haibv10/do-an-thiet-ke-he-thong-so/sw/app/main.c

#include "sys_delay.h"
#include "gpio_led.h"
#include "uart_io.h"
#include "ds3231_rtc.h"
#include "st7735_panel.h"
#include "ui_clock.h"
#include "spi_bus.h"
#include "mq5_sensor.h"
#include "dht11_sensor.h"

// Startup must copy .data from ROM and clear .bss; volatile keeps the check real.
volatile unsigned int data_marker = 0x5a5a5a5a;
volatile unsigned int bss_marker;

int main(void) {
  unsigned char time[DS3231_TIME_BYTES];
  unsigned char last_second = 0xff;
  unsigned int led = 0;
  unsigned int rtc_time_trusted;
  unsigned char command;
  unsigned int gas_tick = 0;
  unsigned int gas_mv;
  unsigned int dht_tick = 0;
  unsigned int dht_pending = 0;
  unsigned int dht_status;
  unsigned int display_fault_reported = 0;
  unsigned char humidity;
  unsigned char temperature;

  led_set(0);

  if (data_marker == 0x5a5a5a5au && bss_marker == 0u) {
    uart_puts("BOOT OK\r\n");
  } else {
    uart_puts("BOOT FAIL data=");
    uart_hex32(data_marker);
    uart_puts(" bss=");
    uart_hex32(bss_marker);
    uart_puts("\r\n");
  }

  tft_init();

  rtc_time_trusted = ds3231_report_osf();

  ui_draw_frame();

  while (1) {
    if (spi_error() && !display_fault_reported) {
      uart_puts("DISPLAY SPI TIMEOUT\r\n");
      display_fault_reported = 1;
    }
    if (uart_poll(&command)) {
      if (command == 'W' && ds3231_set_from_uart())
        rtc_time_trusted = 1;
      else if (command == 'P')
        ui_toggle_page();
    }

    if (++gas_tick >= 10u) {
      gas_tick = 0;
      if (mq5_read_mv(&gas_mv))
        ui_show_gas(gas_mv, mq5_level_of(gas_mv));
      else
        ui_show_gas_fault();
    }

    if (!dht_pending && ++dht_tick >= 40u) {
      dht_tick = 0;
      dht11_start();
      dht_pending = 1;
    }
    if (dht_pending) {
      dht_status = dht11_status();
      if (!(dht_status & DHT11_BUSY)) {
        if (dht11_read(&humidity, &temperature))
          ui_show_environment(temperature, humidity);
        else
          ui_show_environment_fault();
        dht_pending = 0;
      }
    }

    if (!ds3231_read_time(time)) {
      uart_puts("RTC NACK\r\n");
      ui_show_rtc_fault();
      delay_loop(DELAY_MS(1000));
      continue;
    }

    if (time[0] != last_second) {
      last_second = time[0];
      if (rtc_time_trusted && ds3231_time_is_valid(time)) {
        ds3231_print(time);
        ui_show_time(time);
      } else {
        uart_puts("RTC INVALID\r\n");
        ui_show_unset();
      }
      led = led ^ 1u;
      led_set(led);
    }

    delay_loop(DELAY_MS(50));
  }
}
