haibv10/do-an-thiet-ke-he-thong-so/tb/integration/cpu_spi_tb.sv

`timescale 1ns / 1ps

module cpu_spi_tb;
  logic         clk = 1'b0;
  logic         rst_n = 1'b0;
  wire          led_out;
  wire          uart_tx_out;
  wire          spi_sck_out;
  wire          spi_mosi_out;
  wire          spi_cs_n_out;
  wire          spi_dc_out;
  wire          spi_rst_n_out;
  tri1          i2c_sda;
  tri1          i2c_scl;

  time last_sck_rise = 0;
  integer checked_widths = 0;
  always @(posedge spi_sck_out) last_sck_rise = $time;
  always @(negedge spi_sck_out) if (rst_n && last_sck_rise) begin
    if ($time - last_sck_rise != 37)
      $fatal(1, "SPI high width must be one system clock (13.5 MHz at 27 MHz)");
    checked_widths = checked_widths + 1;
  end

  integer       index;
  integer       bit_count = 0;
  integer       byte_count = 0;
  logic   [7:0] shift = 8'd0;
  logic   [7:0] seen_byte      [0:3];
  logic         seen_dc        [0:3];

  always #18.5 clk = ~clk;

  soc_top dut (
    .clk          (clk),
    .rst_n        (rst_n),
    .led_out      (led_out),
    .uart_rx_in   (1'b1),
    .uart_tx_out  (uart_tx_out),
    .i2c_sda      (i2c_sda),
    .i2c_scl      (i2c_scl),
    .spi_sck_out  (spi_sck_out),
    .spi_mosi_out (spi_mosi_out),
    .spi_cs_n_out (spi_cs_n_out),
    .spi_dc_out   (spi_dc_out),
    .spi_rst_n_out(spi_rst_n_out)
  );

  always @(posedge spi_sck_out) begin
    if (rst_n) begin
      shift     = {shift[6:0], spi_mosi_out};
      bit_count = bit_count + 1;
      if (bit_count == 8) begin
        if (byte_count < 4) begin
          seen_byte[byte_count] = shift;
          seen_dc[byte_count]   = spi_dc_out;
        end
        byte_count = byte_count + 1;
        bit_count  = 0;
      end
    end
  end

  initial begin
    #4000000;
    $fatal(1, "timeout after %0d bytes", byte_count);
  end

  initial begin
    #1;
    for (index = 0; index < $size(dut.rom.rom); index = index + 1) dut.rom.rom[index] = 32'h0000_0013;

    dut.rom.rom[0]  = 32'h7000_02b7;
    dut.rom.rom[1]  = 32'h0040_0313;
    dut.rom.rom[2]  = 32'h0062_a423;
    dut.rom.rom[3]  = 32'h03a0_0313;
    dut.rom.rom[4]  = 32'h0062_a023;
    dut.rom.rom[5]  = 32'h0042_a383;
    dut.rom.rom[6]  = 32'h0013_f393;
    dut.rom.rom[7]  = 32'hfe03_9ce3;
    dut.rom.rom[8]  = 32'h0060_0313;
    dut.rom.rom[9]  = 32'h0062_a423;
    dut.rom.rom[10] = 32'h0550_0313;
    dut.rom.rom[11] = 32'h0062_a023;
    dut.rom.rom[12] = 32'h0042_a383;
    dut.rom.rom[13] = 32'h0013_f393;
    dut.rom.rom[14] = 32'hfe03_9ce3;
    dut.rom.rom[15] = 32'h0050_0313;
    dut.rom.rom[16] = 32'h0062_a423;
    dut.rom.rom[17] = 32'h0000_006f;

    repeat (2) @(posedge clk);
    #1;
    if (spi_cs_n_out !== 1'b1) $fatal(1, "cs_n = %b during reset", spi_cs_n_out);
    if (spi_rst_n_out !== 1'b0) $fatal(1, "panel rst_n = %b during reset", spi_rst_n_out);
    if (spi_sck_out !== 1'b0) $fatal(1, "sck = %b during reset", spi_sck_out);

    @(negedge clk) rst_n = 1'b1;

    wait (byte_count == 2);
    repeat (200) @(posedge clk);

    if (byte_count !== 2) $fatal(1, "%0d bytes on the wire, expected 2", byte_count);
    if (seen_byte[0] !== 8'h3a) $fatal(1, "first byte %h, expected 3a", seen_byte[0]);
    if (seen_dc[0] !== 1'b0) $fatal(1, "dc = %b for the command byte, expected 0", seen_dc[0]);
    if (seen_byte[1] !== 8'h55) $fatal(1, "second byte %h, expected 55", seen_byte[1]);
    if (seen_dc[1] !== 1'b1) $fatal(1, "dc = %b for the parameter byte, expected 1", seen_dc[1]);

    if (spi_cs_n_out !== 1'b1) $fatal(1, "cs_n = %b after the deselect store", spi_cs_n_out);
    if (spi_rst_n_out !== 1'b1)
      $fatal(1, "panel rst_n = %b after firmware released it", spi_rst_n_out);

    if (!checked_widths) $fatal(1, "No SPI widths checked");
    $display("cpu_spi_tb: PASS (13.5 MHz divider)");
    $finish;
  end
endmodule
