haibv10/do-an-thiet-ke-he-thong-so/source/memory/mem_instruction_rom.v

module mem_instruction_rom #(
  parameter HEX_PATH = "rom/firmware.hex"
) (
  input  wire        clk,
  input  wire [31:0] a,
  output reg  [31:0] rd,

  input  wire [31:0] a_data,
  output reg  [31:0] rd_data
);
  reg     [31:0] rom   [0:4095];
  integer        index;

  initial begin

    // synthesis translate_off
    for (index = 0; index < 4096; index = index + 1) begin
      rom[index] = 32'd0;
    end
    // synthesis translate_on
    $readmemh(HEX_PATH, rom);
  end

  always @(negedge clk) begin
    rd      <= rom[a[13:2]];
    rd_data <= rom[a_data[13:2]];
  end
endmodule
