haibv10/do-an-thiet-ke-he-thong-so/source/peripheral/i2c/i2c_mmio.v

module i2c_mmio (
  input  wire        clk,
  input  wire        tick,
  input  wire        rst_n,
  input  wire        we,
  input  wire [31:0] a,
  input  wire [31:0] wd,
  output reg  [31:0] rd,
  inout  wire        sda,
  inout  wire        scl
);

  wire       frame_busy;
  wire       frame_ack;
  wire [7:0] frame_data;

  reg        en;
  reg        busy;
  reg  [7:0] tx_data;
  reg        start_frame;
  reg        stop_frame;
  reg        rw;
  reg        ack_out;

  wire       launch = we && (a[7:0] == 8'h00) && !busy;

  i2c_master master_inst (
    .clk        (clk),
    .tick       (tick),
    .rst_n      (rst_n),
    .en         (en),
    .rw         (rw),
    .start_frame(start_frame),
    .stop_frame (stop_frame),
    .ack_out    (ack_out),
    .data       (tx_data),
    .sda        (sda),
    .scl        (scl),
    .done       (),
    .busy       (frame_busy),
    .data_out   (frame_data),
    .ack        (frame_ack),
    .sda_en     ()
  );

  always @(posedge clk or negedge rst_n) begin
    if (!rst_n) begin
      en          <= 1'b0;
      busy        <= 1'b0;
      tx_data     <= 8'd0;
      start_frame <= 1'b0;
      stop_frame  <= 1'b0;
      rw          <= 1'b0;
      ack_out     <= 1'b0;
    end else if (launch) begin
      tx_data     <= wd[7:0];
      start_frame <= wd[8];
      stop_frame  <= wd[9];
      rw          <= wd[10];
      ack_out     <= wd[11];
      en          <= 1'b1;
      busy        <= 1'b1;
    end else if (en && frame_busy) begin
      en <= 1'b0;
    end else if (busy && !en && !frame_busy) begin
      busy <= 1'b0;
    end
  end

  always @(*) begin
    rd = 32'd0;
    case (a[7:0])
      8'h04: begin
        rd[0] = busy;
        rd[1] = frame_ack;
      end
      8'h08:   rd = {24'd0, frame_data};
      default: ;
    endcase
  end

endmodule
