haibv10/do-an-thiet-ke-he-thong-so/(commit log)

2026-08-13 docs: add initial README for RISC-V FPGA SoC
    Document the RV32I five-stage pipeline architecture, memory-mapped UART, GPIO, and I2C peripherals. Include the verified I2C LCD status, project scope, development roadmap, demo goals, verification strategy, and reference tools.
2026-08-24 chore: add repository guidance and ignore rules
    Document the RISC-V RV32I SoC architecture, peripheral responsibilities, FPGA scope, and current development direction.
    Add contributor guidance for SystemVerilog coding style, testing, development commands, and Conventional Commits.
    Ignore generated FPGA, simulation, build, coverage, editor, and temporary files.
2026-08-24 docs: add project documentation and coding rules
    Add I2C/LCD diagrams, waveforms, hardware references, Verilog coding conventions, and commit guidelines.
2026-08-24 feat(i2c): import lcd i2c controller
    Context:
    The LCD demo uses a PCF8574 adapter controlled through a 1 MHz I2C timing domain.
    Changes:
    Import the existing clock divider, I2C write-frame, LCD nibble writer, and LCD display controller without changing their Verilog behavior.
    Verification:
    Not run; no simulator is configured in the repository.
2026-09-06 feat(cpu): import board-tested five-stage pipeline
    The SoC targets the GW1NR-LV9QN88PC6/I5 board at 27 MHz. Team
    baseline commit 58c94bd provides the five-stage RV32I pipeline and its
    board-tested GPIO and UART path. Preserve that Verilog module and
    interface contract before later peripheral work changes the integration.
    Import the IF, ID, EX, MEM, and WB datapath, pipeline registers,
    forwarding, load-use stall detection, and branch and jump flushing. Add
    the 4 KiB instruction and data memories, MMIO decoder, GPIO, 115200 baud
    UART TX, RV32I firmware, and the validated board pin assignments.
    Keep the RTL behavior unchanged apart from replacing the developer
    machine readme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
    [cpu_top.v, main.c, make_hex.py, pipe_ex_mem.v, pipe_id_ex.v, pipe_if_id.v, pipe_mem_wb.v]
2026-09-06 test(cpu): add pipeline and MMIO regression
    The imported CPU baseline needs repeatable verification independent of
    the existing board build artifacts. The regression must cover pipeline
    control and the software-visible paths used by the current firmware.
    Add self-checking tests for the ALU, decoder, immediate generator,
    forwarding unit, load-use hazard detector, and four pipeline registers.
    Add a CPU integration program that exercises forwarding, a load-use
    stall, branch and JAL flushing, subword memory accesses, GPIO MMIO, and
    an 8N1 UART frame containing the byte 0x48.
    Add a test runner and document the GW1NR-LV9QN88PC6/I5 board target and
    the exact Icarus Verilog simu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
    [cpu_top_tb.sv, pipe_ex_mem_tb.sv, pipe_id_ex_tb.sv, pipe_if_id_tb.sv, pipe_mem_wb_tb.sv]
2026-09-07 test(cpu): fix integration test assumptions
    Icarus Verilog 11 rejects the unsigned integer localparam syntax used by
    the CPU integration test. Data Memory also leaves byte lanes undefined
    until software writes them, while the test incorrectly expected every
    unwritten lane to contain zero.
    Use a Verilog-compatible integer parameter for the UART bit period.
    Check only the byte lanes written by SB and SH, while continuing to
    verify signed and unsigned subword load results.
    Include the observed RAM and register values in the failure message so
    a future subword regression identifies the affected path directly.
    bash tb/run_tests.sh passes all ten tests, including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
    [cpu_top_tb.sv]
2026-09-07 build(fpga): add headless Tang Nano 9K flow
    The five-stage CPU baseline needs a reproducible terminal-only FPGA flow
    instead of relying on generated artifacts from another workstation. The
    target is a Tang Nano 9K with a GW1NR-LV9QN88PC6/I5 device and a 27 MHz
    onboard clock.
    Add the Gowin project, Tcl build description, and an explicit 27 MHz SDC
    constraint. Add a Linux wrapper that runs Gowin headlessly with a
    consistent Qt and libstdc++ environment on Ubuntu 22.04.
    Add an SRAM programming wrapper for the FT2232 FT2CH JTAG channel. Use
    SRAM Program without readback because operation 4 reports a verify
    failure at address zero on this target, while operation 2 completes an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
2026-09-07 chore(tooling): move build scripts to tools and output to build
    Runner, firmware, synthesis and programming scripts were scattered across the repository root, sw/ and tb/,
    and each one wrote generated artifacts next to its sources. Gowin emitted impl/ at the root and the RISC-V
    toolchain left ELF, BIN, ASM and MAP files inside sw/.
    Move build_fpga.sh, build_gowin.tcl, program_fpga.sh, tb/run_tests.sh and sw/make_hex.py into tools/, and
    add tools/build_firmware.sh for the RV32I cross-compile. Every script now resolves the repository root from
    its own location and writes to build/sim/, build/firmware/ and build/gowin/. tools/build_fpga.sh symlinks
    build/gowin/src so the rela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
    [make_hex.py]
2026-09-07 feat(uart): add UART RX with MMIO status and read-clear
    The CPU could only transmit. The MMIO decoder reserved 0x50000000 for UART but exposed a single write-only
    data register, so the pipeline had no way to observe incoming serial data on the Tang Nano 9K.
    Add uart_rx.v with a two-flop input synchronizer, start bit revalidation at the half-bit point, LSB-first
    assembly of eight data bits, and byte publication only when the stop bit is high. Add uart_mmio.v to wrap
    the transmitter and receiver behind one decode:
    0x00 write TX data
    0x04 read status, bit 0 tx_busy, bit 1 rx_valid
    0x08 read RX data, the load clears rx_valid
    Wire uart_mmio into cpu_top with a r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
2026-09-07 docs(verification): record UART RX evidence and branching model
    The verification note still described the transmit-only design and the old root-level script paths, and the
    branching model the team agreed on existed only in conversation.
    Update docs/verification/rv32i_pipeline.md with the twelve-test simulation scope, the current post-route
    numbers, the measured UART RX echo results, the single-byte receive buffer limitation, and a bring-up
    procedure. The procedure records three environment hazards found during this bring-up: a stale device
    configuration that emitted a repeated 0x56 until the byte-identical bitstream was reprogrammed, ftdi_sio
    binding the JTAG channel as /d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
2026-09-14 test(i2c): add lcd controller testbenches
    Add simulation coverage for the standalone I2C/LCD controller before it
    is integrated with the RV32I MMIO bus.
    The controller is split into timing generation, I2C frame transmission,
    LCD byte conversion, and LCD display sequencing. Add a focused testbench
    for each layer so failures can be isolated before CPU integration.
    - clk_divider_tb checks the configured output clock division.
    - i2c_writeframe_tb checks START, eight MSB-first data bits, slave ACK,
    STOP, and completion for one I2C frame.
    - lcd_write_cmd_data_tb checks the PCF8574 transfer sequence generated
    when writing an LCD data byte.
    - lcd_display_tb checks the LCD initialization sequen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
2026-09-14 test(uart): add loopback board diagnostic
    Add a self-contained UART loopback design for validating the alternate
    UART signal direction on the FPGA board without changing the CPU SoC
    top-level or its product pin constraints.
    The diagnostic top connects the selected UART output to the matching
    UART input and keeps the LED in a known state.
    - add the dedicated loopback top module and pin constraints
    - add a self-checking simulation for idle, low, and high signal levels
    - add headless Gowin build and programming commands for the diagnostic
    bitstream
2026-09-14 feat(lcd): switch display controller to 20x4
    Replace the fixed 16x2 display sequence with a four-line, 20-character
    controller for the PCF8574 LCD path.
    The controller now accepts four display rows and emits the DDRAM cursor
    commands required by a 20x4 HD44780-compatible display.
    - keep the initialization sequence and command/data write interface
    - add cursor commands 0x80, 0xC0, 0x94, and 0xD4 for the four rows
    - send 80 display characters after initialization
    - register cmd_data together with data so the control type remains
    aligned with the transmitted byte
    - extend the self-checking testbench to cover all 89 output bytes
    lcd_display_tb passes with Icarus Verilog.
2026-09-19 feat(i2c): add memory-mapped i2c peripheral for pcf8574 lcd
    Move the I2C path into the CPU 27 MHz clock domain and step it from a 1 MHz
    tick enable, so a one-cycle MMIO write strobe is no longer missed by a
    separately divided clock.
    The peripheral sits at base 0x60000000: offset 0x00 writes
    {cmd_data, data[7:0]}, 0x04 reads status {ack, busy}, 0x08 sets the 7-bit
    slave address.
    - replace clk_divider with clock_enable_divider as the 1 MHz tick source
    - gate every counter and state update in i2c_writeframe and
    lcd_write_cmd_data on tick instead of a 1 MHz clock input
    - fix the microsecond counters that cleared on every non-tick cycle and
    never reached the 10 and 50 tick delay marks
    - dri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
    [cpu_top.v, cpu_top_tb.sv, dump_vcd.sv, i2c_mmio.v, i2c_mmio_tb.sv]
2026-09-19 build(fpga): add i2c sources to gowin file lists
    The GUI project and the headless Tcl flow each carry their own source list,
    so the new I2C modules were absent from synthesis while the removed
    clk_divider was still referenced.
    - add clock_enable_divider, i2c_writeframe, lcd_write_cmd_data and i2c_mmio
    to fpga_project.gprj and tools/build_gowin.tcl
    - preload the system libfreetype alongside libstdc++ in build_fpga.sh and
    fail early with a clear message when it is missing
    build_fpga.sh completes with Timing analysis completed and Bitstream
    generation completed. program_fpga.sh reaches 100% and Finished.
2026-09-19 feat(lcd): scan pcf8574 address and drive lcd demo from firmware
    The data bus decodes only regions 0x2, 0x4, 0x5 and 0x6, so a load from ROM
    returns zero and .rodata is unreachable. The previous firmware read its hex
    table and the HELLO FPGA string from ROM, which sent NUL bytes over UART and
    left the LCD blank.
    - emit character literals inline instead of reading .rodata tables
    - send BOOT over UART TX before the scan so CPU liveness is observable
    - scan 0x20-0x27 and 0x38-0x3f, report the acknowledging address over UART
    and write HELLO FPGA to the LCD once one is found
    - format hex nibbles without the A-F branch, which the current pipeline
    mis-executes; nibbles above 9 therefore print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
2026-09-19 refactor(repo): separate constraints and drop dead scaffolding
    Keep src/ to RTL only. Pin and timing constraints move to constr/, the
    generated firmware image is no longer duplicated there, and the UART loopback
    diagnostic is removed — docs/verification already recorded that it does not
    belong in the repository.
    - move fpga_project.cst and fpga_project.sdc to constr/
    - keep one firmware image at sw/firmware.hex and give imem a HEX_PATH
    parameter instead of a hardcoded "src/firmware.hex", which also lets a
    testbench run from outside the repository root
    - symlink sw/ into the Gowin build directory so $readmemh resolves
    - delete uart_loopback_top, its constraint, testbench and three buil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
    [dump_vcd.sv]
2026-09-19 fix(lcd): let the standalone display controller refresh
    The Done state fell through to the output block default, which held cnt_clr
    asserted and pinned the counter at zero. The 50 ms refresh comparison could
    therefore never match and the FSM stayed in Done forever after writing the
    first frame.
    - give Done its own output case that releases cnt_clr
    Confirmed by simulating 400k cycles past the first frame: the FSM previously
    stopped at 89 bytes written and never returned to Write.
2026-09-19 refactor: write all source comments in english
    Bring the RTL, firmware and tooling comments in line with the rest of the
    repository, which is already in English.
    - translate every remaining comment in src/, sw/ and tools/
    - drop edit-history markers such as "new wire" and "fixed", which rule 29 of
    the coding style forbids because they go stale as soon as the code changes
    - note in regfile.v that the read ports have no write-first bypass, so an
    instruction in ID reads the old value while WB writes in the same cycle
    Comment-only change. run_tests.sh passes 18/18 and the Gowin build is
    unaffected.
    [cpu_top.v, make_hex.py, pipe_ex_mem.v, pipe_mem_wb.v, uart_tx.v]
2026-09-19 chore(logs): keep only decisive verification evidence
    The directory had grown to 56 files under two parallel naming schemes, none of
    them tracked because .gitignore swallowed every *.log. Evidence cited in the
    documentation therefore existed only on one machine.
    - keep eight logs, numbered along the verification chain: simulation, FPGA
    build, cable check, programming, on-board measurement
    - keep three fault captures that the documentation cites as evidence for the
    known limitations
    - separate the JTAG cable scan from the UART capture; scan_*.log and
    i2c_scan_*.log were different measurements with near-identical names
    - strip the programmer progress-bar animation from the programming l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
2026-09-19 docs: rewrite readme and split hardware and bring-up reference
    The README had grown to five jobs at once: project pitch, architecture spec,
    register map, build commands and board troubleshooting. Split it so the README
    describes the project and how to run it, and move the reference material into
    docs/.
    - restructure README around features, architecture, getting started, hardware
    setup, repository layout, verification and known limitations
    - extract docs/hardware/register_map.md with the per-peripheral registers and
    the access rules each one requires
    - extract docs/bringup.md with the board pitfalls: always reprogram before
    measuring, telling the external UART node from the FT2232 JTAG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
2026-09-19 refactor(repo): complete the source tree move
    The previous commit recorded the file moves and deletions but none of the
    content changes that go with them, leaving the branch inconsistent: imem still
    read the deleted src/firmware.hex, the test runner still invoked the removed
    loopback testbench, and both Gowin file lists still pointed at the old
    constraint paths.
    - give imem a HEX_PATH parameter defaulting to sw/firmware.hex
    - stop build_firmware.sh writing the second copy into src/
    - symlink sw/ instead of src/ into the Gowin build directory
    - point build_gowin.tcl and fpga_project.gprj at constr/ and sw/firmware.hex,
    and group the Tcl file list by function
    - drop uart_loopback_top_tb fro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
2026-09-19 fix(i2c): generate a real stop condition and release sda from reset
    PreStop released SCL while SDA was already high, so the SDA rising edge that
    defines a STOP never appeared on the bus; what the analyser saw instead was a
    tenth SCL rising edge with no falling edge after it. Separately sda_out had no
    reset value, so with sda_en reset high the master pulled SDA low from power-up
    until the first frame. Both testbenches that should have caught this counted a
    STOP on any SDA rising edge while SCL was high, with no requirement that a START
    had happened first, and the x-to-1 settle of the unreset driver satisfied that
    before the frame began.
    - drive SDA low in AckDone, while SCL is still low, so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
2026-09-19 fix(cpu): bypass the register file on a same-cycle write
    The forwarding unit reaches back to EX/MEM and MEM/WB, which covers RAW
    dependencies one and two instructions apart. At distance three the producer
    writes the register file in the same cycle the consumer reads it in ID, and the
    combinational read ports returned the stale value: a directed program computed
    0 + 5 instead of 4 + 5. This is the defect behind the firmware printing 0x27 as
    2>, which the hex formatter has been working around by branching.
    - return the pending write data from rd1/rd2 when we is high and rd matches the
    index being read, leaving x0 and the write-disabled case untouched
    - add regfile_tb covering the bypass and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
    [cpu_hazard_tb.sv]
2026-09-19 feat(cpu): add auipc and open a rom window on the data bus
    Opcode 0010111 was absent from the decoder and the immediate generator, so it
    retired silently without writing its destination, and the address decoder had no
    case for region 0x0, so a load aimed at ROM returned zero. The linker puts
    .rodata and the load image of .data in ROM, so between them these two gaps made
    string literals, lookup tables and initialised globals unusable from C.
    - add ALUSrcA, a control bit selecting the program counter instead of rs1 for
    the ALU A input, carried from the control unit through ID/EX into a mux in EX
    - decode AUIPC and give it the U-type immediate it shares with LUI
    - give imem a second read por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
2026-09-19 feat(sw): copy .data and clear .bss before entering main
    startup.s set the stack pointer and jumped straight to main. The linker gave
    .data a load address in ROM and a run address in RAM but nothing performed the
    copy, and .bss was never cleared, so any global held whatever the RAM powered up
    with. The copy reads through the ROM window added in the previous commit.
    - export _data_lma, _data_start, _data_end, _bss_start, _bss_end and _stack_top
    from the linker script, and place _start in its own section at address 0
    - copy .data out of ROM and zero .bss in startup.s before calling main
    - build with -msmall-data-limit=0, so nothing lands in .sdata or .sbss and no
    gp-relative addressing is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
2026-09-19 refactor(rtl): keep only the comments that carry a reason
    Comments restating the line below them made the ones worth reading harder to
    find: every state in the I2C frame machine carried an identical delay 10us note,
    and most port declarations repeated their own names.
    - drop comments that add nothing over the code they sit on
    - replace the remaining ones with the constraint or consequence behind the line,
    such as the divider ratio that yields 50 kHz SCL and the reason both memories
    read on the falling edge
    - record the PCF8574 pin mapping and the five-frame nibble sequence once at the
    top of lcd_write_cmd_data instead of repeating the bit layout per state
    No functional change. The re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
    [pipe_mem_wb.v, uart_tx.v]
2026-09-19 docs: add a fix log and refresh every recorded figure
    The documentation still described defects fixed in this branch and carried
    post-route numbers from the previous build. It also stated that the I2C NACK
    path skips the ninth SCL pulse; measurement showed the opposite, an extra tenth
    rising edge, with the ninth always present.
    - add docs/fix_log.md recording all nine findings with the evidence before and
    after each fix, the post-route comparison and what is still open
    - register the four new testbenches in run_tests.sh, taking the suite to 22
    - update the instruction count to 37 of 40, add region 0x0 to the memory map and
    describe the startup sequence and the boot banner
    - replace the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
2026-09-19 docs: correct the pcf8574 address and record the board measurement
    The documentation stated that this backpack answers at 0x21 rather than the
    usual 0x27, citing logs/05-board-uart.log. That reading was itself produced by
    the register file defect and was never an address: a PCF8574 with A0, A1 and A2
    left open answers at 0x27, and logs/08-fault-hex-branch.log already carried the
    answer, since '0' + 7 is '7' and 'A' - 10 + 7 is '>', so the low nibble of the
    mangled I2C 2> was 7 all along. A build carrying the bypass reads I2C 27.
    - add finding 10 to the fix log covering the misattributed address, and correct
    the claim in the readme, design report, bring-up notes, register map and
    verific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
2026-09-19 fix(soc): synchronise every input that crosses into the clock domain
    Three signals with no relationship to the 27 MHz clock were consumed directly.
    rst_n comes off a mechanical button and drove the asynchronous reset pin of
    every sequential block: asserting that way is deliberate, but releasing that way
    puts the rising edge wherever the contact bounces, so recovery and removal
    cannot be met and nothing guarantees all 1594 registers leave reset on the same
    cycle. btn_in was read combinationally into the GPIO read mux, and sda was
    sampled for the ACK bit straight off the pad. uart_rx_in already had a two-stage
    chain, so the technique was present but unevenly applied.
    - add reset_sync.v: async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
    [cpu_top.v, reset_sync.v, reset_sync_tb.sv]
2026-09-19 docs: record the clock domain boundary and refresh the figures
    - add finding 11 to the fix log, with the timing cost and the evidence that the
    binding path is the half-cycle memory read rather than the reset
    - add a design report section on the boundary with the outside world: why
    assertion is asynchronous but release is not, and why synchronising is not
    debouncing
    - correct a stale claim that region 0x0 is absent from the decoder and that ROM
    is unreachable over the data bus, which the ROM window replaced
    - renumber the design report sections after the insertion
    - record the remaining open items: no debounce on the user button, and 7% timing
    margin limited by the half-cycle read
    -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
2026-09-19 test: cover the five modules that had no testbench
    address_decoder, dmem, imem, pc_reg and uart_tx were exercised only through
    cpu_top_tb. The ROM window and the byte lanes are both recent and neither had a
    test that named them.
    - address_decoder_tb: each region selects one target, unmapped regions read
    zero, the byte mask reaches RAM unchanged, and a store into the ROM window
    reaches nothing at all
    - dmem_tb: each byte lane on its own, a halfword mask, a zero mask behaving as a
    read, the 4 KB wrap, and a read concurrent with a write returning the old word
    - imem_tb: both ports reading independently and the same word at once, and the
    array past the end of the image reading zero rath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
2026-09-19 docs: audit the figures and cite the ones that hold up
    Every file in docs/images/ was unreferenced, and that was the problem: because
    nothing cited them, nothing had ever checked what they contain. Three did not
    belong to this project at all. demo.jpg showed an Avnet Zynq board driving a
    16x2 LCD with another person's name on it, schematic_1.png was a Vivado block
    design around a Zynq UltraScale+ processing system, and pin_out.png was a
    Quartus pin table for a keypad lock on an Altera part.
    - delete those three
    - rewrite docs/images/README.md as an inventory: what each remaining file shows,
    which are superseded captures of this project, and which are unattributed
    reference material that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
2026-09-19 refactor(rtl): organize CPU and protocol source ownership
    The RTL and test tree no longer made ownership visible, and the build graph still referenced the removed src/ and tb/ paths.
    - group CPU RTL under source/cpu with cpu_, core_, pipe_ and mem_ names
    - group SoC-specific adapters under source/peripheral and shared logic under source/common
    - keep reusable I2C and UART RTL beside their unit testbenches in libs/
    - group non-library testbenches under sim/ by ownership
    - update the Gowin project, headless build and simulation source lists
    Verification: 29/29 self-checking testbenches pass. Gowin completes synthesis, place and route, timing analysis and bitstream generation; SRAM programmin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
    [clock_enable.v, clock_enable_tb.sv, core_alu.v, core_alu_tb.sv, core_control.v, core_control_tb.sv, core_immediate.v, core_immediate_tb.sv]
2026-09-19 docs: record the source layout refactor evidence
    The repository documentation still described the removed src/ and tb/ layout, and the source-layout refactor had no recorded verification chain.
    - document source/, libs/ and sim/ ownership in the README and design report
    - update module names in the register map, verification report, coding guide and firmware helper
    - add the 29-test simulation, FPGA build and SRAM-programming logs to the log inventory
    - record source-layout verification in the fix log, including the unchanged timing and resource figures
    - distinguish successful SRAM programming from a persisted UART/LCD capture
    Verification: simulation passes 29/29; Fmax is 28.912 MHz agai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
    [make_hex.py]
2026-09-20 docs: correct UART and I2C bring-up instructions
    README directed users to /dev/ttyUSB0 even though that node can be
    an FT2232 interface rather than the external USB-UART module. Opening the
    wrong interface can interfere with JTAG access instead of capturing UART.
    Document discovery through /dev/serial/by-id and update the expected PCF8574
    address to 0x27. Mark the old 0x21 capture as historical faulty firmware so
    it is not presented as current board behavior.
    No RTL, firmware, simulation, FPGA build, or board programming changes.
2026-09-20 uart: add receive FIFO and overrun status
    The receive path held one byte and silently overwrote it when another valid frame arrived before software read the UART data register. Historical sustained-stream measurements exposed the loss but could not report it to firmware.
    Queue received frames in a 16-byte ring buffer. Preserve the oldest queued byte when the buffer is full, drop only the new byte, and record a sticky overrun. Keep the existing TX and RX data offsets, expose FIFO level and overrun in the status register, and clear overrun with a W1C control register.
    Add unit, MMIO, and CPU-level FIFO tests. The full suite passes 30/30 and the Gowin build completes at 30.210 MHz with no set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
2026-09-20 uart: validate receive FIFO on board
    The UART FIFO board test initially failed because firmware wrote the
    rx_overrun status value 0x04 to the W1C control register. The control
    register clears overrun only when bit 0 is written as 1.
    Use a separate 0x01 control value, report each burst case independently,
    and add regression coverage for an ineffective 0x04 W1C write.
    The board protocol now passes ordered 16-byte reception, 17-byte overrun
    handling, and W1C clear. Simulation passes 30/30; FPGA build, SRAM
    programming, and the corrected board protocol all pass.
    [main.c, uart_mmio_tb.sv]
2026-09-20 cpu: suppress false load-use stalls
    LUI, AUIPC and JAL immediate fields were compared as register sources by
    the load-use hazard unit. A matching field inserted a bubble even though the
    instruction did not read that register.
    Add decoder source-use flags and gate hazard comparisons with them. Extend
    decoder, hazard and CPU tests so LUI and AUIPC following loads do not stall,
    while a real load-use dependency still stalls once.
    Stop tracking local logs and reference PDFs. The files remain local through
    .gitignore, while documentation keeps their paths as plain-text provenance.
    Simulation passes 30/30. Gowin timing analysis and bitstream generation pass;
    the resulting bitstream programs into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
    [core_control.v, core_control_tb.sv, cpu_hazard_tb.sv, cpu_top.v, pipe_hazard.v, pipe_hazard_tb.sv]
2026-09-20 gpio: remove unused button input
    GPIO no longer exposes S1 as a software input. Remove the btn_in port,
    its synchronizer, the GPIO read register at offset 0x04, and FPGA pin 4.
    GPIO now owns only the active-low LED register at 0x40000000. Update
    integration tests, pin constraints and project documentation accordingly.
    Simulation passes 31/31. FPGA timing and bitstream generation pass; the
    resulting bitstream programs into SRAM at 100% with Finished.
    [cpu_auipc_tb.sv, cpu_fence_tb.sv, cpu_firmware_boot_tb.sv, cpu_hazard_tb.sv, cpu_top.v, cpu_top_tb.sv, cpu_uart_fifo_tb.sv, cpu_uart_hex_tb.sv]
2026-09-21 spi: add mode 0 write-only master with mmio wrapper
    The ST7735 breakout on this board brings only SDA out to its header, so
    the link to the panel can never be anything but write-only. Giving the
    master a miso port and a receive register would leave logic with nothing
    driving it.
    Add a mode 0, MSB first, 8 bit shift engine with no receive path.
    CLK_DIV sets the sck half period in clk cycles and defaults to 2, which
    gives 6.75 MHz out of the 27 MHz domain, inside the ST7735 write cycle
    limit with margin for jumper wiring.
    Keep busy set for one further half period after the last bit. Software
    moves cs_n and dc as soon as busy clears, and without that trailing
    state either line could change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
2026-09-21 cpu: map the spi peripheral at region 0x7
    The address decoder selects on addr[31:28] alone. Regions 0x4, 0x5 and
    0x6 were already taken by GPIO, UART and I2C, and 0x7 read back zero as
    unmapped, so SPI takes it.
    Add we_spi and rd_spi following the existing rule that RAM takes the
    full byte mask while a peripheral takes bit 0 as an enable. Instantiate
    spi_mmio in cpu_top and expose the five pins.
    Constrain them to 25 through 29 at LVCMOS33. Those are the only run of
    bank 2 header pins on the Tang Nano 9K with nothing else wired to them;
    36 through 39 sit next to them but belong to the TF card slot, and the
    rest of bank 2 is committed to the RGB LCD connector. Pull up cs_n and
    the panel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
2026-09-21 build: add the spi sources to the gowin file list
    tools/run_tests.sh collects CPU sources with a glob, but
    tools/build_gowin.tcl names every file by hand. A module added to the
    tree therefore passes every testbench while never reaching synthesis,
    and the only symptom is the top module quietly becoming a black box:
    ERROR (EX3937) : Instantiating unknown module 'spi_mmio'
    Module 'cpu_top' remains a black box due to errors in its contents
    Nothing in the test suite can catch this, because the suite never reads
    the synthesis file list. Add both SPI sources to build_gowin.tcl, and
    to fpga_project.gprj so the IDE flow matches the headless one.
    The build now runs through to bitstream genera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
2026-09-21 tft: draw st7735 colour bars from firmware
    Bring up the 128x160 panel hanging off the SPI peripheral. The first
    frame is colour bars rather than text because a bar reports byte order,
    the MADCTL scan direction and column addressing at once, while text
    stays readable when any of the three is wrong.
    Limit the init sequence to commands the datasheet specifies: SWRESET,
    SLPOUT with the 120 ms wait from 10.1.11, COLMOD set to 0x55 as 10.1.29
    note 2 requires for 16 bit writes, MADCTL, INVOFF, NORON and DISPON.
    Leave the power control and frame rate registers at their reset
    defaults; their recommended values come from the panel vendor rather
    than from the controller datasheet, and nothing so far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
    [main.c]
2026-09-21 lcd: remove the driver from firmware scope
    The 20x4 HD44780 panel is being retired and a DS3231 will take its place
    on the I2C bus, so the shipped firmware should stop driving it.
    Remove the LCD helpers, the LCD register defines and I2C_BASE from
    main.c. The main loop now prints ALIVE once a second and toggles the
    LED instead of reporting the PCF8574 address. A periodic line is worth
    keeping: it distinguishes a hung CPU from a capture that never reached
    the terminal, which is exactly the ambiguity that cost time while the
    transmit FIFO was being debugged, and the LED is the same evidence
    without a terminal. Firmware drops from 2412 to 2000 bytes.
    Leave the I2C RTL alone. pcf8574_lcd_mm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
2026-09-21 docs: describe the spi register map and st7735 bring-up
    Document the registers at 0x70000000: the data, status and control
    offsets, the reset state that leaves the panel deselected and held in
    reset, and the release sequence firmware has to perform. Record that
    the link is write-only, so nothing can be read back from the panel and
    firmware has to rely on datasheet delays.
    Add the five pins to the README hardware table together with the 3V3
    supply note and the reason the backlight is tied to 3V3 rather than an
    IO pin, update the memory map and feature list, and mark the I2C block
    as present in hardware but no longer driven by the firmware.
    Add three fix log entries: the synthesis file list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
2026-09-21 i2c: remove the lcd peripheral from the design
    Firmware stopped driving the HD44780 panel when the LCD left firmware
    scope, which left the RTL instantiated and synthesized with nothing on
    the other end of the bus. A DS3231 will take region 0x6 over, and it
    needs to read slave registers, which a write-only frame engine cannot do.
    Delete pcf8574_lcd_mmio.v, i2c_pcf8574_lcd_write.v,
    i2c_lcd_20x4_refresh.v and their testbenches. Remove the I2C instance
    and its clock enable from cpu_top, drop the i2c_sda and i2c_scl ports
    and the two pin constraints, and take we_i2c and rd_i2c out of the
    decoder so region 0x6 reads zero as unmapped until the DS3231 lands.
    Eight CPU testbenches lose the two tri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
2026-09-21 i2c: carry frames in both directions
    The block could only write. A register read on this bus has no command
    of its own: the pointer is set with a write, the bus is turned around
    with a repeated START, and the slave transmits until the master refuses
    a byte. None of that was reachable.
    Replace i2c_write_frame.v with i2c_master.v, adding rw, ack_out and
    data_out. rw is latched when the frame begins, so moving it mid-transfer
    cannot turn the data phase around while it is running. A read releases
    sda for the eight data bits and samples each one at the midpoint of the
    scl high time, where the slave holds it steady rather than at an edge
    where it is free to move it. The acknowledge bit is dr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
    [cpu_address_decoder.v, cpu_address_decoder_tb.sv, cpu_auipc_tb.sv, cpu_fence_tb.sv, cpu_firmware_boot_tb.sv, cpu_hazard_tb.sv, cpu_spi_tb.sv, cpu_top.v]
2026-09-21 docs: describe the i2c master and its registers
    Record the registers at 0x60000000: the single frame register with its
    four flags, the busy and acknowledge status bits, and the data register,
    together with the sequence of stores that reads a slave register and the
    reason the last byte of a read has to be refused.
    Update the block diagrams, the address maps and the resource figures for
    a bus that fans out to four peripherals again, and correct the testbench
    count in the README, which still said 34 after three LCD testbenches were
    removed.
    The chapter describing the old LCD state machines is kept and re-marked:
    it is the record of the frame engine the new master grew out of, not a
    descriptio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
2026-09-21 sw: read the ds3231 timekeeping registers
    Prove the new I2C path against a real device rather than only against a
    model. Read the seven timekeeping registers once a second and print
    them, so a wiring fault, a stopped oscillator and a working clock each
    look different on the terminal.
    Set the register pointer with a write, turn the bus around with a
    repeated START, acknowledge every byte but the last and refuse that one
    with a STOP. A slave transmits until it is refused, so acknowledging
    all seven would leave the read with no end. Reading from register 0 also
    snapshots the time inside the part, so the seven bytes cannot straddle a
    tick and need no reread.
    The registers hold BCD, so print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
    [cpu_i2c_tb.sv, main.c]
2026-09-21 sw: report the oscillator stop flag at boot
    The timekeeping registers always read back something, so a clock whose
    oscillator has stopped is indistinguishable from one that is running
    until two reads are compared. The part already answers the question: bit
    7 of the status register at 0x0f is set whenever the oscillator stops,
    including the first time power is applied, and stays set until it is
    written back to zero.
    Read it once after the panel comes up and print whether it is set. It is
    not printed with every time line, because it cannot change while VCC is
    present: the oscillator only stops when both VCC and the backup cell are
    too low to sustain it, and the CPU is not running in that ca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
    [main.c]
2026-09-21 sw: set the clock from the build timestamp
    The part has never been set, so it counts from its power-on default and
    the oscillator stop flag stays set. Nothing on this board knows the
    time, with one exception: the compiler knows when it ran, and __DATE__
    and __TIME__ carry that into .rodata.
    Add a write path to the driver and a UART command that writes the build
    timestamp into the seven timekeeping registers. The clock is then a few
    minutes behind whenever the image was programmed, and keeps time from
    there.
    Clear the oscillator stop flag afterwards, and only afterwards. The flag
    means the registers have not been counting since they were last written,
    so a known value in them is what mak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
    [main.c]
2026-09-21 docs: record the ds3231 bring-up
    Two entries. The delay helper counted iterations while its name said
    clocks, which made every delay nine times its intended length; the fix
    log carries the nine-second and one-second captures on either side of the
    correction. The second entry covers the write path, the oscillator stop
    flag and setting the clock from the build timestamp, with the host check
    of the timestamp conversion and the board capture of the value reading
    back.
    State plainly that the stop flag reading after a reset has not been
    captured, so clearing it is inferred from the write path rather than
    observed.
2026-09-21 sw: show the date and time on the panel
    The panel has been showing colour bars since it came up, which proved the
    link but says nothing afterwards. Draw the clock on it instead.
    Add an 8x8 ASCII font covering 32 through 126, lifted from the console
    font at /usr/share/consolefonts/Uni2-VGA8.psf.gz, whose first 128 entries
    follow ASCII. A glyph is drawn into its own address window, so a redraw
    touches 64 pixels rather than a line, and both colours are written so a
    character can replace the one under it without a clear.
    Redraw when the seconds byte changes, not on a timer. A timer drifts
    against the clock: an earlier capture shows 00:14:52 followed by
    00:14:54, because the loop waited a se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
    [main.c]
2026-09-21 docs: record the panel clock
    Entry 32 covers the font, the redraw on the seconds byte, and the three
    consequences that came with them: the UART RX FIFO board test retired to
    free ROM, the move to -Os when that was still short, and the delay
    calibration that -Os invalidated, which corrects the figure entry 30
    recorded.
    Carry the evidence that the redraw no longer drifts: 373 consecutive
    readings over five minutes with no repeated and no skipped second,
    against the earlier capture that skipped one.
    State the consequence of embedding the build timestamp, which is that
    sw/firmware.hex never reproduces and shows as modified after every build.
2026-09-21 memory: double the instruction ROM to 8 KB
    An 8x8 ASCII font and the code that draws it overflowed the 4 KB ROM by
    296 bytes. That was paid for once by retiring a board test and once by
    moving the build to -Os, which left 252 bytes: enough to link, not enough
    to work in. The device has the room. 468 Kbit of BSRAM sits in 26
    blocks and the design uses 8.
    Take 2048 words and index on a[12:2], give region 0 a length of 8K, and
    pad the image to the new depth. The testbenches that fill the array by
    hand cover it, and mem_instruction_rom_tb moves its wrap case to 8 KB and
    adds one at 4 KB, which is now inside the ROM rather than a wrap.
    Bracket the zero-fill loop with translate_off. GowinSy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
2026-09-21 sw: return to -O1 now that the font fits
    -Os was adopted to squeeze the font into a 4 KB ROM, and the ROM is now
    8 KB. Move the build back and restore DELAY_MS to the 3000 iterations a
    millisecond that the board measured, which -Os had invalidated.
    The disassembly confirms the five-instruction loop is back: five
    instructions, one taken branch at two cycles and two load-use stalls at
    one each, which is the nine clocks the figure rests on.
    Firmware is 4392 bytes, genuinely past 4 KB, so the shipped image is now
    what exercises the new depth rather than a probe: pROM 8, BSRAM 12 of 26,
    Fmax 31.317 MHz with no violated endpoints. The suite passes 33/33.
    [main.c]
2026-09-21 docs: record what the board showed after the ROM grew
    Three things the documents still described as unproven are now in a
    capture, so they are recorded as observed rather than inferred.
    The 4392 byte image boots and reaches its main loop. That is the proof
    the oversized probe could only stand in for: code above 0x1000 lives in
    the half of the ROM that did not exist before, and a board that runs has
    fetched from it.
    The oscillator stop flag reads clear after a reset. Entry 31 recorded
    clearing it as inferred from the write path because no reset had been
    captured since; one has, and the clock reads the real date rather than
    the power-on default, so the write reached the part and survived t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
2026-09-21 tft: turn the panel the right way up
    MADCTL was 0xc8, which mirrors both the row and the column order, so the
    image was upside down. Nothing caught it until there was text on the
    panel: the first frame was three vertical colour bars, and red, green and
    blue read the same way up as they do upside down.
    Clear D7 MY and D6 MX, leaving 0x08. Clearing both together rotates
    through 180 degrees rather than mirroring about one axis, so the glyphs
    stay readable instead of coming out reversed. D3 stays set, because the
    bars come out red, green and blue in that order and that bit is what
    decides it.
    The panel is still 128 by 160, so every drawing coordinate is unchanged.
    Landscape would not be one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
    [main.c]
2026-09-21 chore: make the branch model and the CI triggers agree
    git_flow.md listed feat/*, release/*, fix/* and hotfix/*. The CI push
    trigger listed feat/**, fix/**, chore/** and release/**. Neither list is
    a subset of the other, so two prefixes behaved unlike the rest.
    hotfix/* was in the branch model and not in the trigger, so the branch
    type meant for an urgent production fix was the one type that ran no
    checks on push. chore/* was in the trigger and not in the model, so it
    ran checks while being undocumented.
    There was also no prefix for a documentation change, so a pull request
    touching only documents had to borrow fix/*, which is what happened to
    the record of the board results.
    Add docs/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
2026-09-21 docs: describe the peripherals the design actually has
    Chapter 6 described three peripherals. Two of them were wrong and two
    were missing.
    The UART section said the receiver holds exactly one byte with no FIFO
    and no overrun flag. That has not been true since the receive queue was
    added: it holds sixteen, drops rather than displaces when full, latches a
    sticky overrun flag cleared by a write-one-to-clear register, and reports
    its level. The register table was missing that register and three of the
    status bits.
    The I2C section described the PCF8574 and the LCD, a peripheral that has
    been removed. It now describes the master that replaced it: frames in
    both directions, one store per fram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
2026-09-21 tft: give the panel an interface and the clock a real time source
    The panel showed two lines of white text at one size, which proved the
    path and looked like a test fixture. Draw the time at double size, where
    eight glyphs of sixteen pixels fill the width exactly, put the date under
    it at single size, and add a title bar, a matching foot and two icons.
    The icons are eight by eight like the font, so a single drawing routine
    serves both and they cost their sixteen bytes of table; the scale factor
    repeats each glyph pixel rather than storing a second font.
    The first palette was a blue bar with a light blue rule and date, and it
    read badly. Blue is the channel the eye is least sensitive to an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
    [main.c]
2026-09-21 sw: split the firmware by layer and move what is not source
    main.c had grown to 778 lines holding the register map, two bus drivers,
    two device drivers, a font, the screen layout and the boot sequence. Its
    directory also held the linker script, which is build configuration, and
    firmware.hex, which is a generated artifact committed only because the
    RTL reads it at elaboration.
    Split the source by layer and name it the way the RTL is named, subsystem
    first: uart_io, i2c_bus, spi_bus, ds3231_rtc, st7735_panel, font_8x8,
    ui_clock, sys_delay, gpio_led, and main.c for the boot and the loop.
    Each module owns the registers it drives, so changing the UART no longer
    means opening a header shared wit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
    [cpu_firmware_boot_tb.sv, ds3231_rtc.c, ds3231_rtc.h, gpio_led.h, i2c_bus.c, i2c_bus.h, main.c]
2026-09-21 docs: record the board result for the firmware layout
    A layout change has to prove the behaviour did not move, so the capture
    is recorded against the seams the split could have broken: .rodata still
    reachable after hex_digits became private to uart_io, the panel still
    initialising after spi_set_control moved into spi_bus, and the clock
    still answering after the direct register read became i2c_last_byte.
2026-09-21 ds3231: refuse stopped and impossible calendar time
    The oscillator-stop flag was printed at boot but did not affect the
    clock displayed on the panel. A DS3231 can retain BCD-shaped registers
    after power loss while OSF says they are untrustworthy, and the firmware
    presented those values as a real clock.
    The BCD check also accepted values outside their field ranges. 0x69
    seconds, 0x29 hours, 0x19 month, 12-hour mode and 30 February all passed
    it. The UART setter independently accepted any date through 31 for every
    month before calculating and writing a weekday.
    Make ds3231_report_osf return the boot trust state and keep the UI at
    NOT SET until a successful UART set operation writes a valid t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
    [ds3231_rtc.c, ds3231_rtc.h, ds3231_rtc_tb.c, main.c, mem_instruction_rom.v]
2026-09-22 release: prepare the source handover tree
    The development tree mixed the buildable project with CI configuration,
    design reports, diagrams, historical fix records, internal workflow rules
    and local debug evidence. Those files are useful while developing the
    system but are not required to build, program or operate the board.
    Keep only the reproducible source package: constraints, synthesizable
    RTL, protocol libraries, testbenches, firmware, the committed ROM image,
    the Gowin project and the command-line tools. Remove the tracked
    documentation, internal rules, GitHub workflow and the unused VCD helper.
    Ignored build and log directories remain local evidence and are not part
    of the handover br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
    [cpu_i2c_tb.sv, dump_vcd.sv, i2c_mmio_tb.sv]
2026-09-22 readme: state the project objective explicitly
    The opening paragraph describes the hardware but leaves the purpose to be
    inferred from the implementation details.
    Add a short objective after the introduction: build a complete FPGA-based
    digital system around the five-stage RV32I processor, use I2C to read the
    DS3231, SPI to display the clock on the ST7735, and UART to communicate
    with the host.
2026-09-22 readme: describe the implemented rv32i processor
    The project introduction names RV32I but does not explain what the CPU
    implements, leaving the central part of the design less documented than
    the attached peripherals.
    Add a short processor section covering the base integer operations,
    branches and jumps, sub-word and word memory access, LUI and AUIPC, the
    five pipeline stages and the hardware used for hazards.
    State the boundaries as well: FENCE is a legal no-op in this in-order
    core, ECALL and EBREAK are absent, and multiplication, division, floating
    point, caches, virtual memory and an operating system are outside the
    design.
2026-10-24 Add MQ5 and DHT11 sensor support
2026-11-01 build: enforce LF scripts and ignore generated artifacts
    - Enforce LF line endings for shell scripts so Windows checkouts run in WSL.
    - Ignore firmware binaries, FPGA bitstreams, simulation output, reports and
    Python caches; preserve the committed ROM image and simulation HEX fixtures.
    - Validate ignore rules and staged whitespace; all 34 existing tests passed
    on the updated develop checkout.
2026-11-01 docs: align project title and environmental monitoring scope
    - Update the project title to reflect the RISC-V environmental monitoring SoC.
    - Describe temperature, humidity and MQ-5 voltage monitoring alongside RTC functions.
    - Clarify voltage-based gas indications and refresh source tree descriptions.
2026-11-07 refactor: clean up source and organize core testbenches
    - consolidate 33 RTL testbenches and support files under tb/
    - remove the DS3231 application unit test
    - remove unused pipeline signals and I2C wrapper wires
    - remove TFT color-bar demo, demo logs and startup delay
    - update build instructions and regenerate the firmware ROM image
    - checked: firmware build succeeded; 33/33 tests passed
    - FPGA synthesis and hardware validation were not run
2026-11-07 refactor: organize release source by responsibility
    - separate CPU, bus, memory and peripheral RTL; rename top to soc_top
    - organize firmware into startup, HAL, drivers, graphics and application
    - mirror RTL responsibilities in tb and separate SoC integration tests
    - remove source comments while preserving build and synthesis directives
    - update Gowin project, firmware build and test paths
    - consolidate release documentation into README
    - remove project decision notes and machine-specific Gowin path
    - checked: 33/33 tests passed; firmware ROM unchanged
    - Gowin synthesis and place-and-route completed; bitstream generated
    - hardware programming was not performed
2026-11-08 feat: modularize RISC-V SoC and strengthen MMIO validation
    - Extract standalone CPU and enforce memory address boundaries
    - Fix SPI timing and add bounded HAL polling
    - Add MMIO demo, memory reports and regression tests
    - Update firmware image, build tooling and documentation
2026-11-08 feat: expand SoC ROM to 16 KiB and RAM to 8 KiB
    - Update memory depths, address decoding, linker and ROM image
    - Extend tests for upper memory regions and address boundaries
    - Document expanded memory capacities
2026-11-08 feat: add UART RTC synchronization script
    - Synchronize DS3231 with laptop time in Vietnam timezone
    - Verify firmware acknowledgement and RTC readback
    - Add UART simulation tests and usage documentation
2026-11-08 feat: improve TFT UI and increase peripheral bus speeds
    - Add dashboard and history with partial updates and crisp bitmap fonts
    - Set SPI to 13.5 MHz and I2C to 100 kHz
    - Optimize address decoding and verify UI rendering and bus timing
2026-11-10 refactor: remove unused code, tests and tooling
    - Drop the unused 8x8 font and TFT drawing helpers; the panel driver keeps only init and blit
    - Remove the MMIO demo app and the APP build switch
    - Keep eight core RTL testbenches and run SPI at the board divider (CLK_DIV=1)
    - Remove firmware/UI tests, formatter tooling and the Gowin IDE project file
    - Simplify the memory report, Makefile targets, .gitignore and README
2026-11-10 test: simplify testbenches to happy-path checks
    - Rewrite all testbenches to run the normal use case once and check the result
    - Add cpu_isa_tb covering the remaining RV32I instructions inside the SoC
    - Remove cpu_hazard_tb, which duplicated the cpu_top_tb program
    - Use bit-asymmetric test bytes so a wrong bit order fails
    - Add a timeout to each waiting testbench and update the README test table
2026-11-10 refactor: trim unused firmware helpers and simplify build scripts
    - Share one binary-to-BCD helper between the RTC driver and the UI
    - Print BCD time fields with uart_hex8 and drop the duplicate uart_bcd
    - Remove unused spi_clear_error, DHT11_FAULT and the MMIO poll override
    - Drop the unused pixel coverage argument in the UI renderer
    - Use one FLASH_FREQ setting and align programming error hints
    - Reduce .gitignore to the build directory and local files
    - Document every place that fixes the memory size
2026-11-10 feat: make boot and RTC status messages readable
    - Print BOOT OK after checking .data/.bss init, or BOOT FAIL with the values
    - Replace RTC OSF SET/CLEAR with RTC OK or RTC TIME LOST and how to fix it
    - Expect BOOT OK in the firmware boot testbench and update the README
